ELFROTomaszFronczek/ESP8266_FAN_Controller/scheme/scheme.pdf

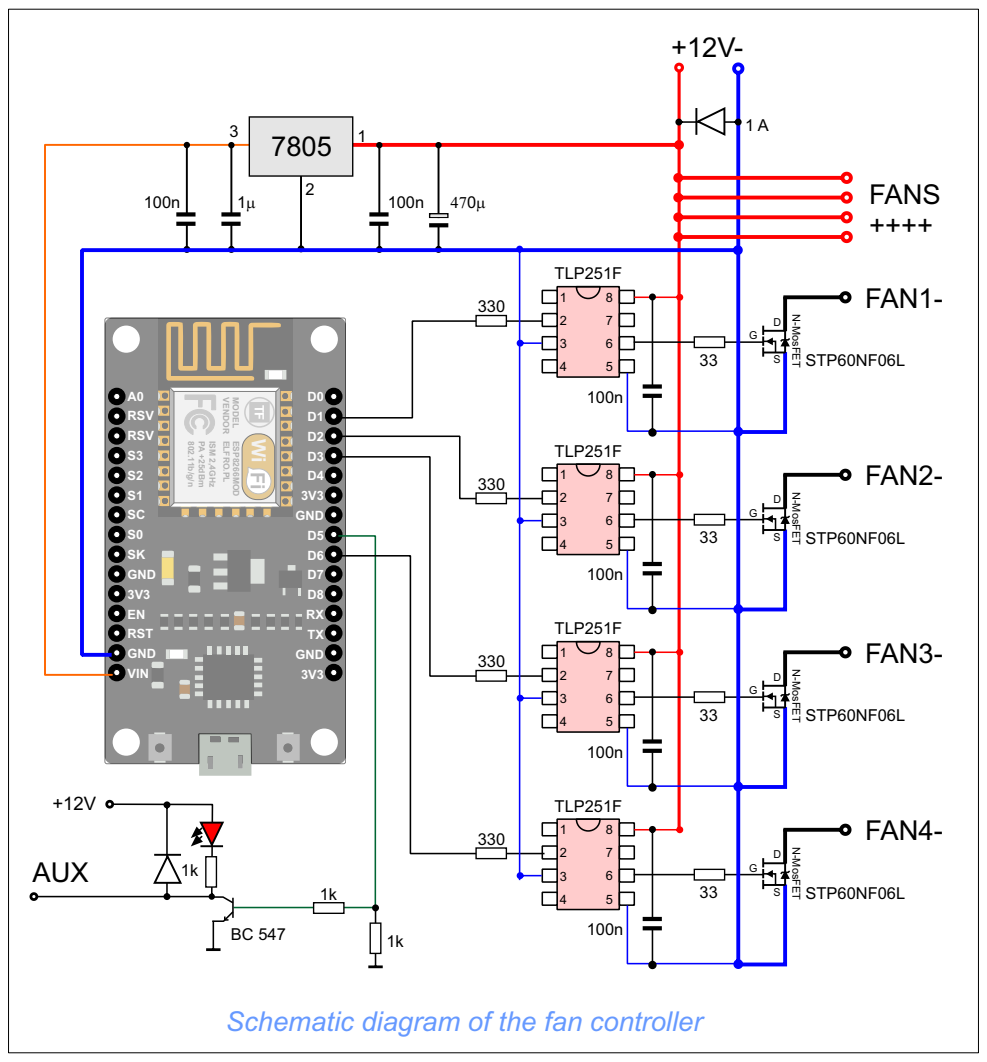
[picture p6: page 1]

Schematic diagram of the fan controller

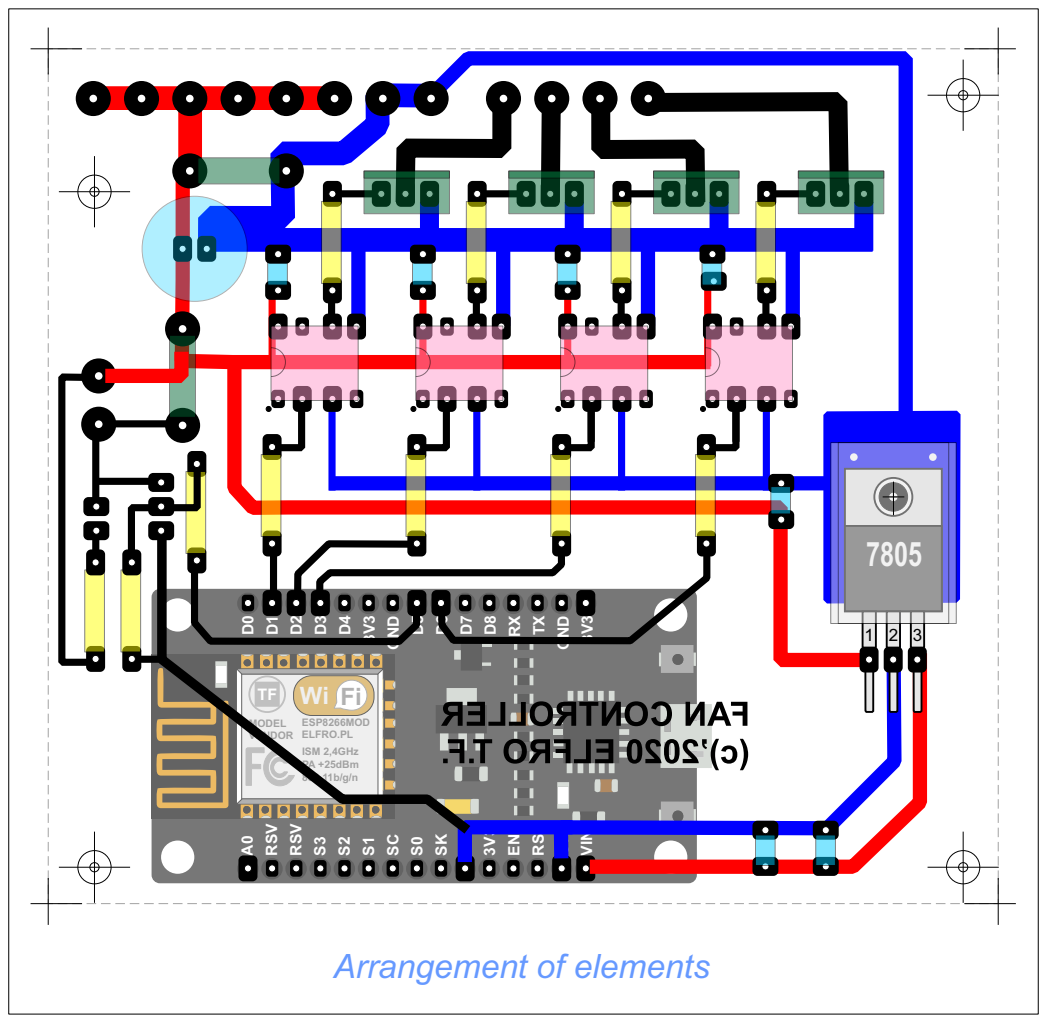
[picture p7: page 2]

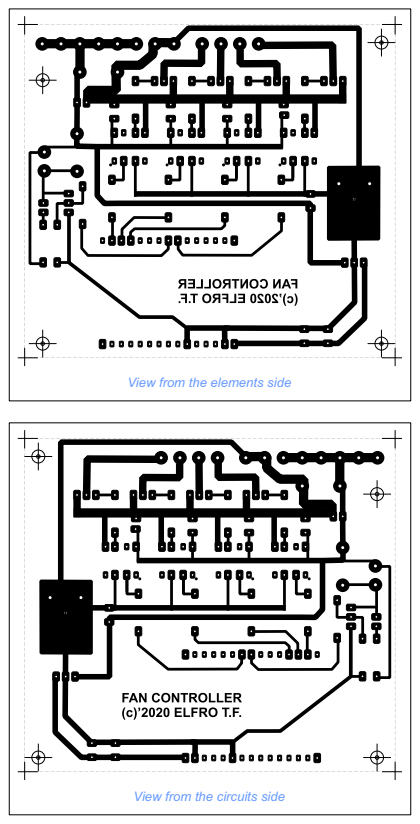
[picture p8: page 3]

View from the elements side

View from the circuits side
