ELFROTomaszFronczek/ESP8266_FAN_Controller/(threads)

Thread 1 (2024-10-07):

which wire of the 4-pin PWM fan corresponds to FAN1-/FAN2-/FAN3-/FAN4-?

bbluvgg, 2024-10-07:
In your circuit diagram, which wire of the 4-pin PWM fan corresponds to FAN1-/FAN2-/FAN3-/FAN4-? What is the purpose of the capacitor across pins 8 and 5 of the TLP251 in the diagram?

ELFROTomaszFronczek, 2024-10-09:
The capacitor is simply in the specifications of this chip.
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

ELFROTomaszFronczek, 2024-10-09:
The outputs are visible in the diagram
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

Closed 2024-10-09.
